WCP52/outputamp/pcb/renders/render_2l_small.png

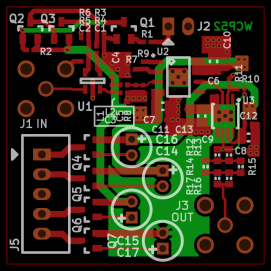
pcb/renders/render_2l_small.png
