WCP52/outputamp/pcb/renders/render_3d_small.png

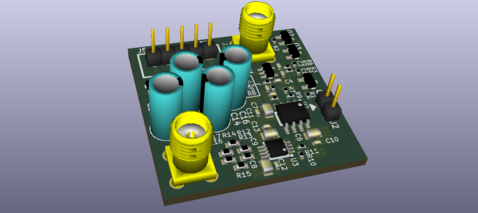
pcb/renders/render_3d_small.png
