WCP52/outputamp/pcb/renders/render_lyr1.png

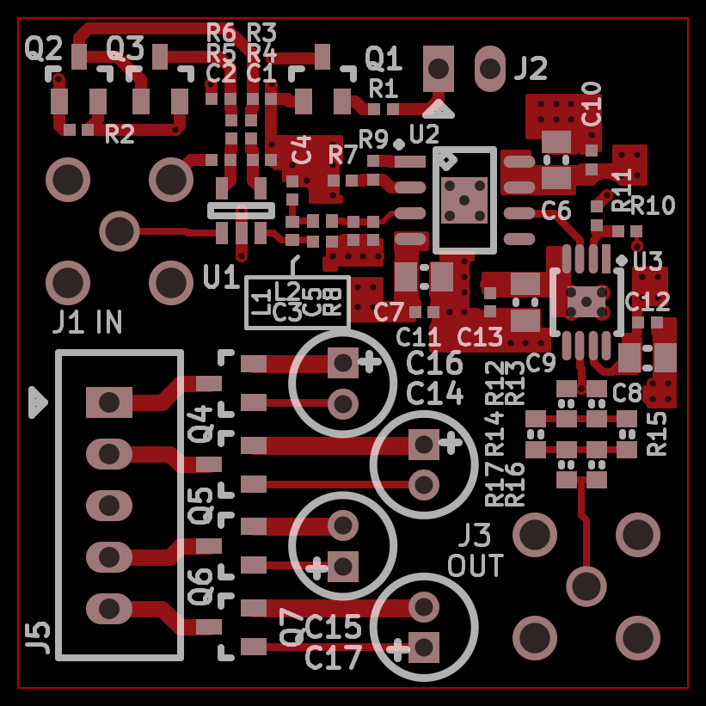
pcb/renders/render_lyr1.png
