WCP52/outputamp/pcb/renders/render_lyr2.png

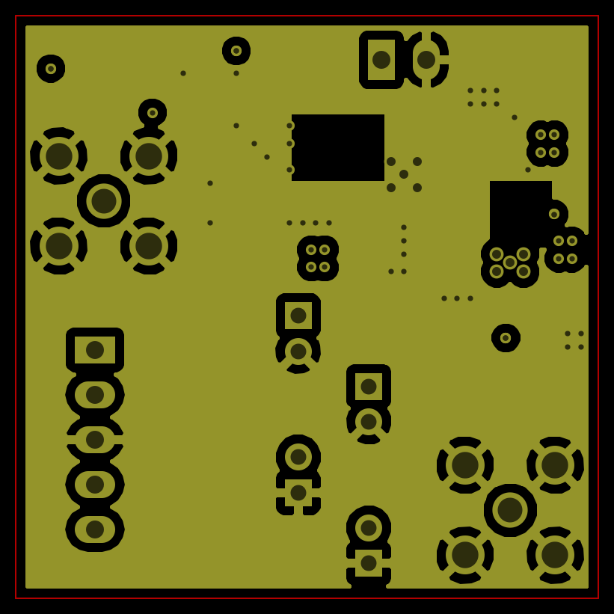
pcb/renders/render_lyr2.png
