WCP52/outputamp/pcb/renders/render_lyr4.png

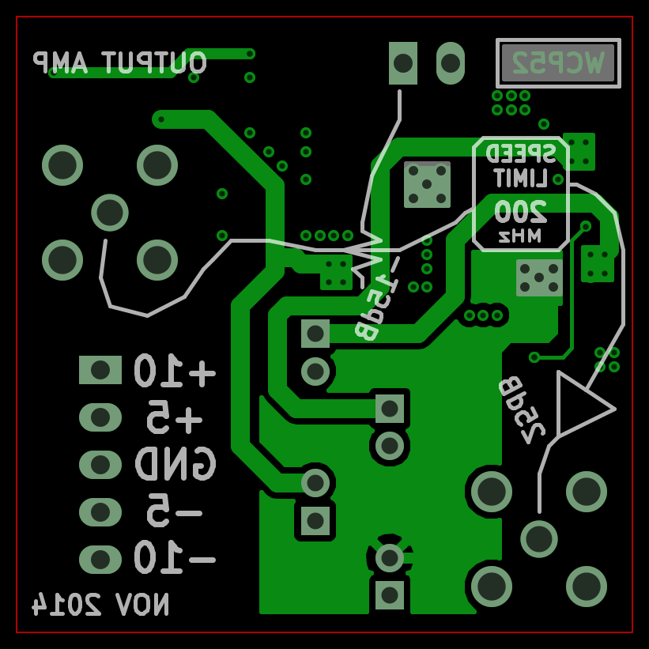
pcb/renders/render_lyr4.png
