WCP52/outputamp/pcb/renders/schematic_small.png

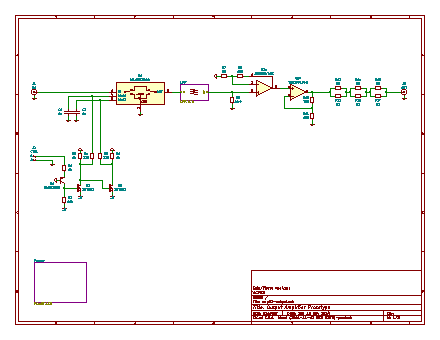
pcb/renders/schematic_small.png
