WCP52/outputamp/pcb/vig.png

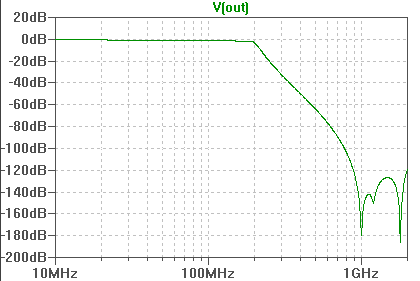
pcb/vig.png
