WCP52/outputamp/sim-filter-cauer/sim-filter-cauer.asc

C1: cap; {mc(22p,0.02)}; Rser=0.3 Lser=512p
C2: cap; {mc(1p5,0.05)}; Rser=1 Lser=676p
C3: cap; {mc(56p,0.02)}; Rser=0.27 Lser=314p
C4: cap; {mc(4p7,0.05)}; Rser=0.4 Lser=215p
C5: cap; {mc(22p,0.02)}; Rser=0.3 Lser=512p
C6: cap; {mc(4p7,0.05)}; Rser=0.4 Lser=215p
C8: cap; {mc(22p,0.02)}; Rser=0.3 Lser=512p
C9: cap; {mc(18p,0.02)}; Rser=0.3 Lser=352p
C10: cap; {mc(4p7,0.05)}; Rser=0.4 Lser=215p
C11: cap; {mc(56p,0.02)}; Rser=0.27 Lser=314p
L1: ind; {mc(56n,0.05)}; Rser=1.4 Cpar=800f
L2: ind; {mc(47n,0.05)}; Rser=1.3 Cpar=540f
L3: ind; {mc(47n,0.05)}; Rser=1.3 Cpar=540f
R1: res; 50
R2: res; 50
V1: voltage; AC 2
Named nets: 0
.ac dec 50 1Meg 1G
22pF: GRM1555C1H220GA01D
56nH: CIH05T56NJNC
47nH: CIH05T47NJNC
1p5: 1276-1071-1-ND
18p: CL05C180JB5NNNC
4p7: CL05C4R7CB5NNNC
56pF: 1276-1707-1-ND
.step param dummy 1 1000 1
