WCP52/outputamp/sim/outputamp.asc

C2: cap; 33p
C3: cap; 47p
C4: cap; 33p
L1: ind; 43n
L2: ind; 43n
R1: res; 50
R2: res; 50
R3: res; 150
R5: res; 180
R6: res; 36
R7: res; 71.629
R8: res; 50
R9: res; 71.629
R10: res; 50
R11: res; 136.14
R12: res; 750
T1: tline; Td=1n Z0=50
U1: AD8000
U2: opamp2; THS3001
V1: voltage; 10
V2: voltage; -10
V3: voltage; 5
V4: voltage; -5
V5: voltage; SINE(0 0.24 {freq}); AC 2
Named nets: 0, V+, V-, in, out2, +5, -5, out
.param freq=100Meg
.tran 0 {50/freq} 0 {.05/freq}
;ac dec 50 1Meg 1G
.lib THS3001.sub
5th order Chebyshev LP filter
fc = 200 MHz
Output
Connector
.lib LM7171.sub
.param RF1 180
.param RF2 750
