WCP52/outputamp/pcb/wcp52-output.kicad_pcb

## KiCad design pcb/wcp52-output.kicad_pcb (2014-11-17)

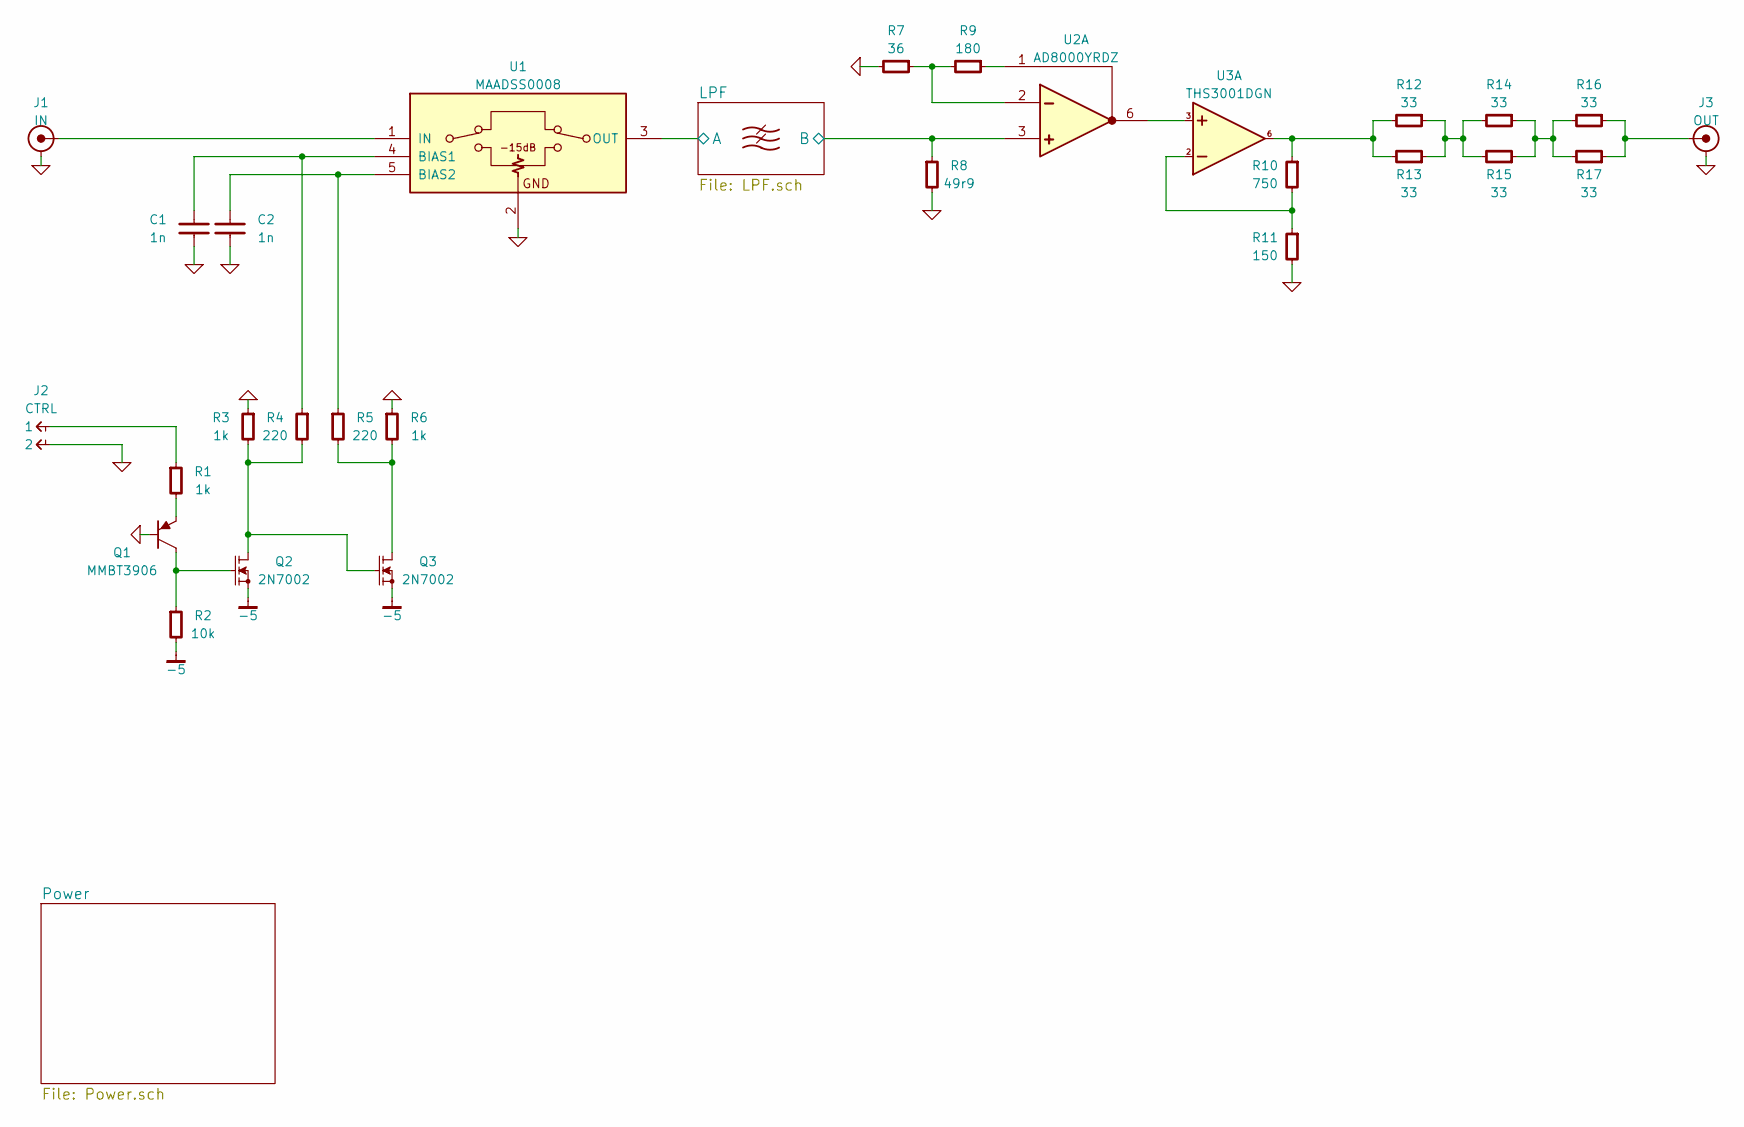
[picture p11: schematic wcp52-output.sch, Output Amplifier Prototype]

Parts:
C1, C2: 1n; CAPC1005X55
J1: IN; CONN-2_CONSMA001
J2: CTRL; CONN_2-SIL
J3: OUT; CONN-2_CONSMA001
Q1: MMBT3906; SOT-23
Q2, Q3: 2N7002; SOT-23
R1, R3, R6: 1k; RESC1005X40
R2: 10k; RESC1005X40
R4, R5: 220; RESC1005X40
R7: 36; RESC1005X40
R8: 49r9; RESC1005X40
R9: 180; RESC1005X40
R10: 750; RESC1005X40
R11: 150; RESC1005X40
R12, R13, R14, R15, R16, R17: 33; RESC1608X50
U1: MAADSS0008; SOT-23-5
U2: AD8000YRDZ; SOIC127P600X175-9
U3: THS3001DGN; SOP65P490X110-9A

Connections:
-5: Q2.2, Q3.2, R2.2; also elsewhere on the board
/LPF/A: U1.3 (OUT); also elsewhere on the board
/LPF/B: R8.1, U2.3; also elsewhere on the board
GND: C1.2, C2.2, J1.2, J2.2, J3.2, Q1.1, R3.1, R6.1, R7.2, R8.2, R11.2, U1.2, U2.9; also elsewhere on the board
unnamed: C1.1, R4.1, U1.4 (BIAS1)
unnamed: C2.1, R5.1, U1.5 (BIAS2)
unnamed: J1.1, U1.1 (IN)
unnamed: J2.1, R1.1
unnamed: J3.1, R16.1, R17.1
unnamed: Q1.2, R1.2
unnamed: Q1.3, Q2.1, R2.1
unnamed: Q2.3, Q3.1, R3.2, R4.2
unnamed: Q3.3, R5.2, R6.2
unnamed: R7.1, R9.2, U2.2
unnamed: R9.1, U2.1
unnamed: R10.1, R12.2, R13.2, U3.6
unnamed: R10.2, R11.1, U3.2
unnamed: R12.1, R13.1, R14.2, R15.2
unnamed: R14.1, R15.1, R16.2, R17.2
unnamed: U2.6, U3.3

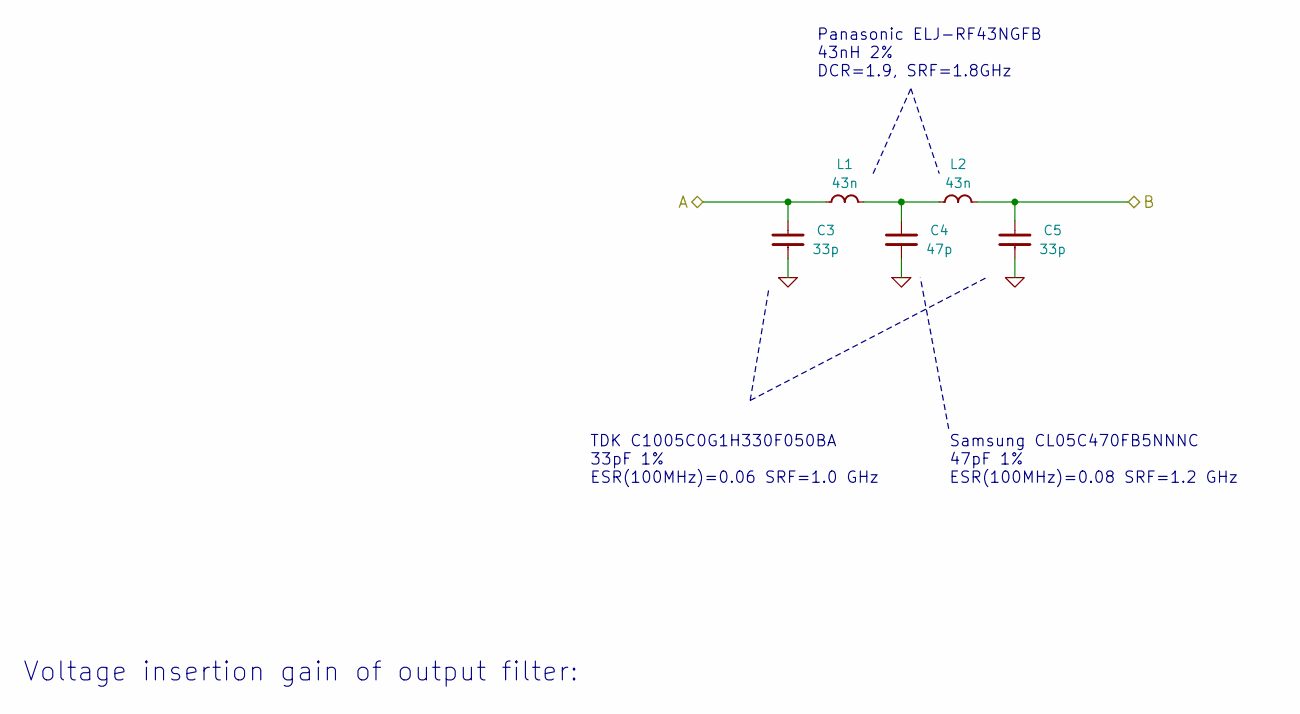
[picture p12: schematic LPF.sch, Output Amplifier Prototype]

Parts:
C3, C5: 33p; CAPC1005X55
C4: 47p; CAPC1005X55
L1, L2: 43n; INDC1005X60

Connections:
/LPF/A: C3.1, L1.2; also elsewhere on the board
/LPF/B: C5.1, L2.1; also elsewhere on the board
GND: C3.2, C4.2, C5.2; also elsewhere on the board
unnamed: C4.1, L1.1, L2.2

Notes on the sheet:
Panasonic ELJ-RF43NGFB 43nH 2% DCR=1.9, SRF=1.8GHz
TDK C1005C0G1H330F050BA 33pF 1% ESR(100MHz)=0.06 SRF=1.0 GHz
Samsung CL05C470FB5NNNC 47pF 1% ESR(100MHz)=0.08 SRF=1.2 GHz
Voltage insertion gain of output filter:

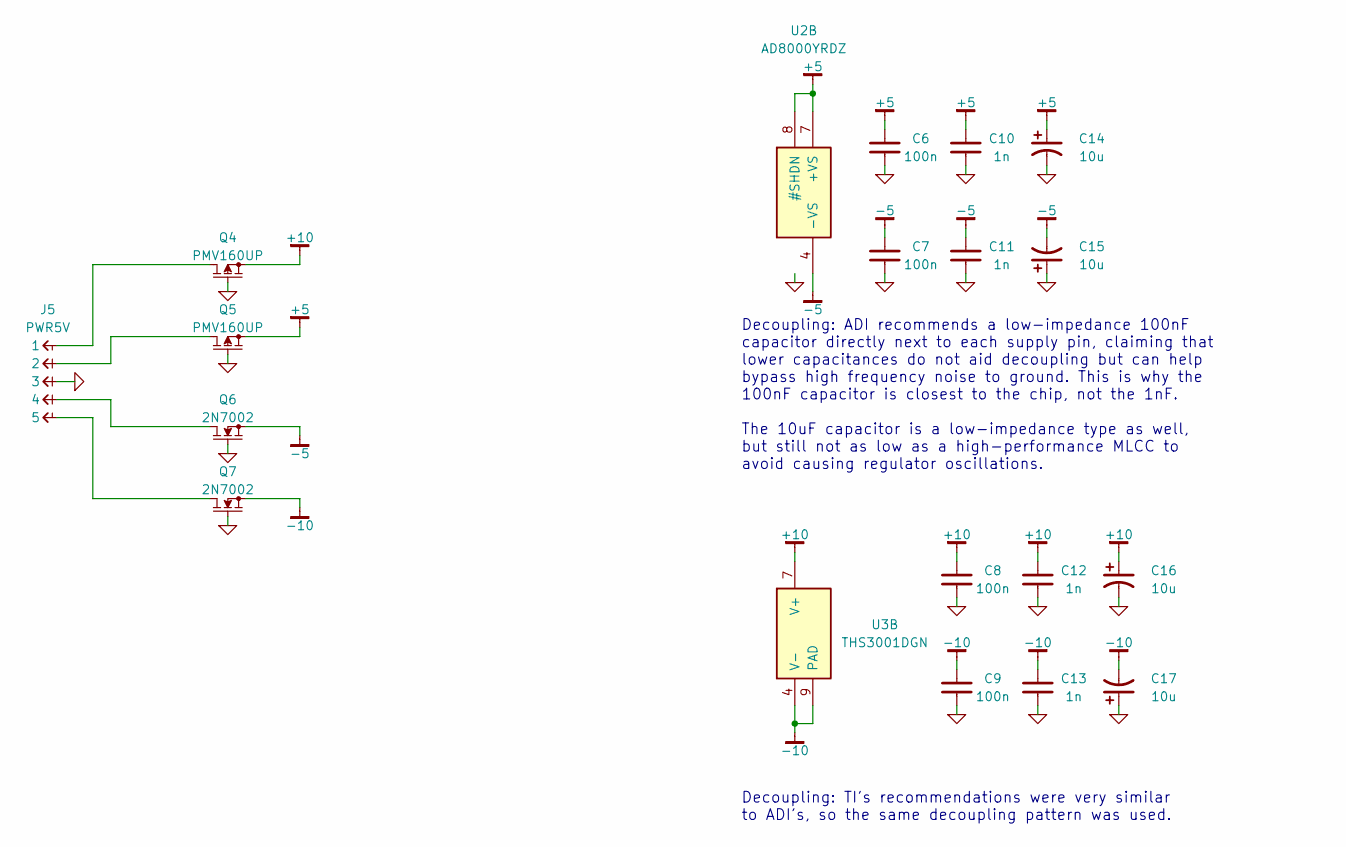
[picture p13: schematic Power.sch, Output Amplifier Prototype]

Parts:
C6, C7, C8, C9: 100n; CAPC2012X70
C10, C11, C12, C13: 1n; CAPC1005X55
C14, C15, C16, C17: 10u; C-ALUM-5mm
J5: PWR5V; CONN_5-SIL
Q4, Q5: PMV160UP; SOT-23
Q6, Q7: 2N7002; SOT-23
U2: AD8000YRDZ; SOIC127P600X175-9
U3: THS3001DGN; SOP65P490X110-9A

Connections:
+5: C6.1, C10.1, C14.1, Q5.2, U2.7 (+VS), U2.8 (#SHDN)
+10: C8.1, C12.1, C16.1, Q4.2, U3.7 (V+)
-5: C7.1, C11.1, C15.2, Q6.2, U2.4 (-VS); also elsewhere on the board
-10: C9.1, C13.1, C17.2, Q7.2, U3.4 (V-), U3.9 (PAD)
GND: C6.2, C7.2, C8.2, C9.2, C10.2, C11.2, C12.2, C13.2, C14.2, C15.1, C16.2, C17.1, J5.3, Q4.1, Q5.1, Q6.1, Q7.1, U2.9; also elsewhere on the board
unnamed: J5.1, Q4.3
unnamed: J5.2, Q5.3
unnamed: J5.4, Q6.3
unnamed: J5.5, Q7.3

Notes on the sheet:
Decoupling: ADI recommends a low-impedance 100nF capacitor directly next to each supply pin, claiming that lower capacitances do not aid decoupling but can help bypass high frequency noise to ground. This is why the 100nF capacitor is closest to the chip, not the 1nF. The 10uF capacitor is a low-im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
Decoupling: TI's recommendations were very similar to ADI's, so the same decoupling pattern was used.

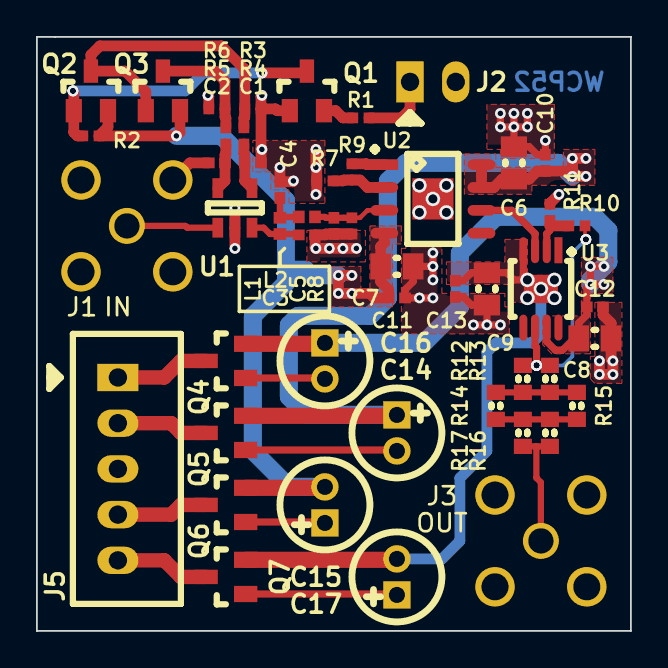
[picture p14: board wcp52-output.kicad_pcb from above]

Board: 4 copper layers, 33.0 x 33.0 mm, 50 parts (0 on the bottom side), 28 nets.
