WCP52/outputamp/(commit log)

2014-11-16 Some schematic work
    [LPF.sch, Power.sch, wcp52-output.sch]
2014-11-16 Copper is likely complete
    [LPF.sch, Power.sch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]
2014-11-16 Silkscreen touchups
    [wcp52-output.GBL, wcp52-output.GBO, wcp52-output.GBS, wcp52-output.GKO, wcp52-output.GTL, wcp52-output.GTO, wcp52-output.GTS, wcp52-output.XLN]
2014-11-16 Removed old comment from schematic
    [Power.sch]
2014-11-17 More PCB touchups
    [wcp52-output.GBL, wcp52-output.GBO, wcp52-output.GBS, wcp52-output.GKO, wcp52-output.GTL, wcp52-output.GTO, wcp52-output.GTS, wcp52-output.XLN]
2014-11-17 Fixed FET part numbers
    [LPF.sch, Power.sch, wcp52-output.sch]
2015-02-17 Added simulation of elliptical filter
